yopnano/CtrlAccesPoulduPiscineArduino/docs/Fusion360/Armoire Electrique (Vue ISO).png

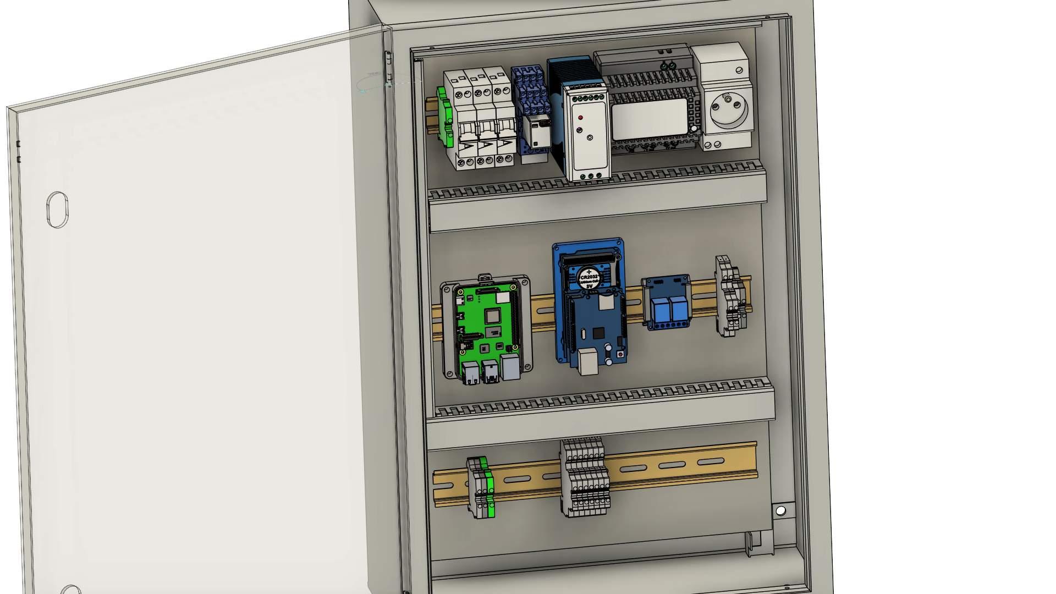
docs/Fusion360/Armoire Electrique (Vue ISO).png
