yopnano/CtrlAccesPoulduPiscineArduino/docs/Fusion360/Armoire 2D.pdf

1 A 2 3 4 5 6 7 8 1 2 3 4 5 6 7 8 FEDCB FEDCBA Dept. Technical reference Created by Approved by Title DWG No. Document type Document status Rev. Date of issue Sheet 24/03/2025 B 15/03/2025 1/1 Piscine Contrôle d'accès Yann Herledan Q1 Q2 Q3 KA1 A1 PC Raspberry PI Arduino RTC X2 X3 KA2 KA3 X1 X4 Repère Désignation Q1 Disjoncteur 16A (Prise) Q2 Disjoncteur 2A (Alimentation) Q3 Disjoncteur 2A (Onduleur) KA1 Relais de présence tension A1 Alimentation 5V 10A 50W (Système) A2 Alimentation 12V 5A 60W (Ventouse) PC Prise de courant console Raspberry PI Raspberry Pi 4B+ 4Go ram RTC Module d'horloge temps réel Arduino Arduino Mega 2560 + Ethernet Shield KA2 Relais de pilotage ventouse magnétique KA3 Relais maintien alimentation ondulée X1 Bornier de source d'alimentation secteur X2 Bornier de distribution terre X3 Bornier de distribution 5V et 5V (batterie) X4 (Ventouse, Bouton poussoir, Digicode RFID) Bornier de raccordement périphérie exterieur A2

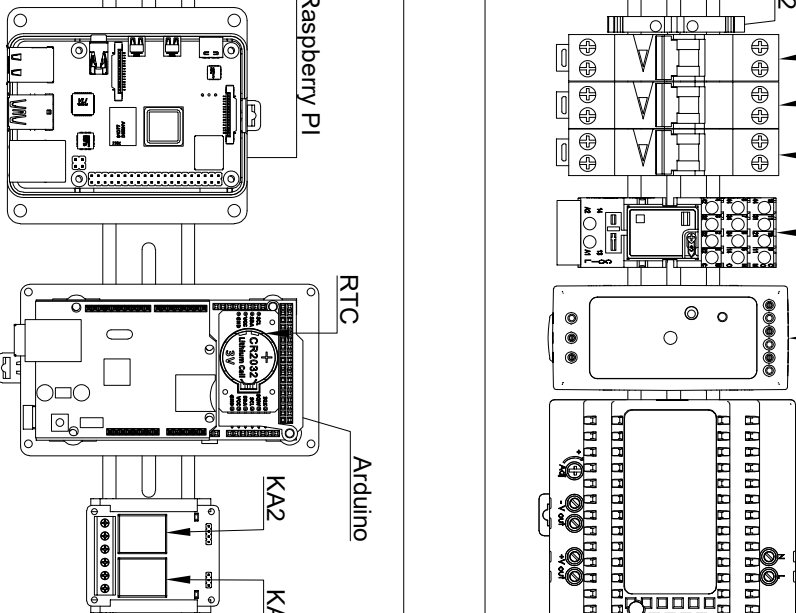
[picture p2: figure]
