yopnano/CtrlAccesPoulduPiscineArduino/docs/Schemaplic/Schema (rev B).pdf

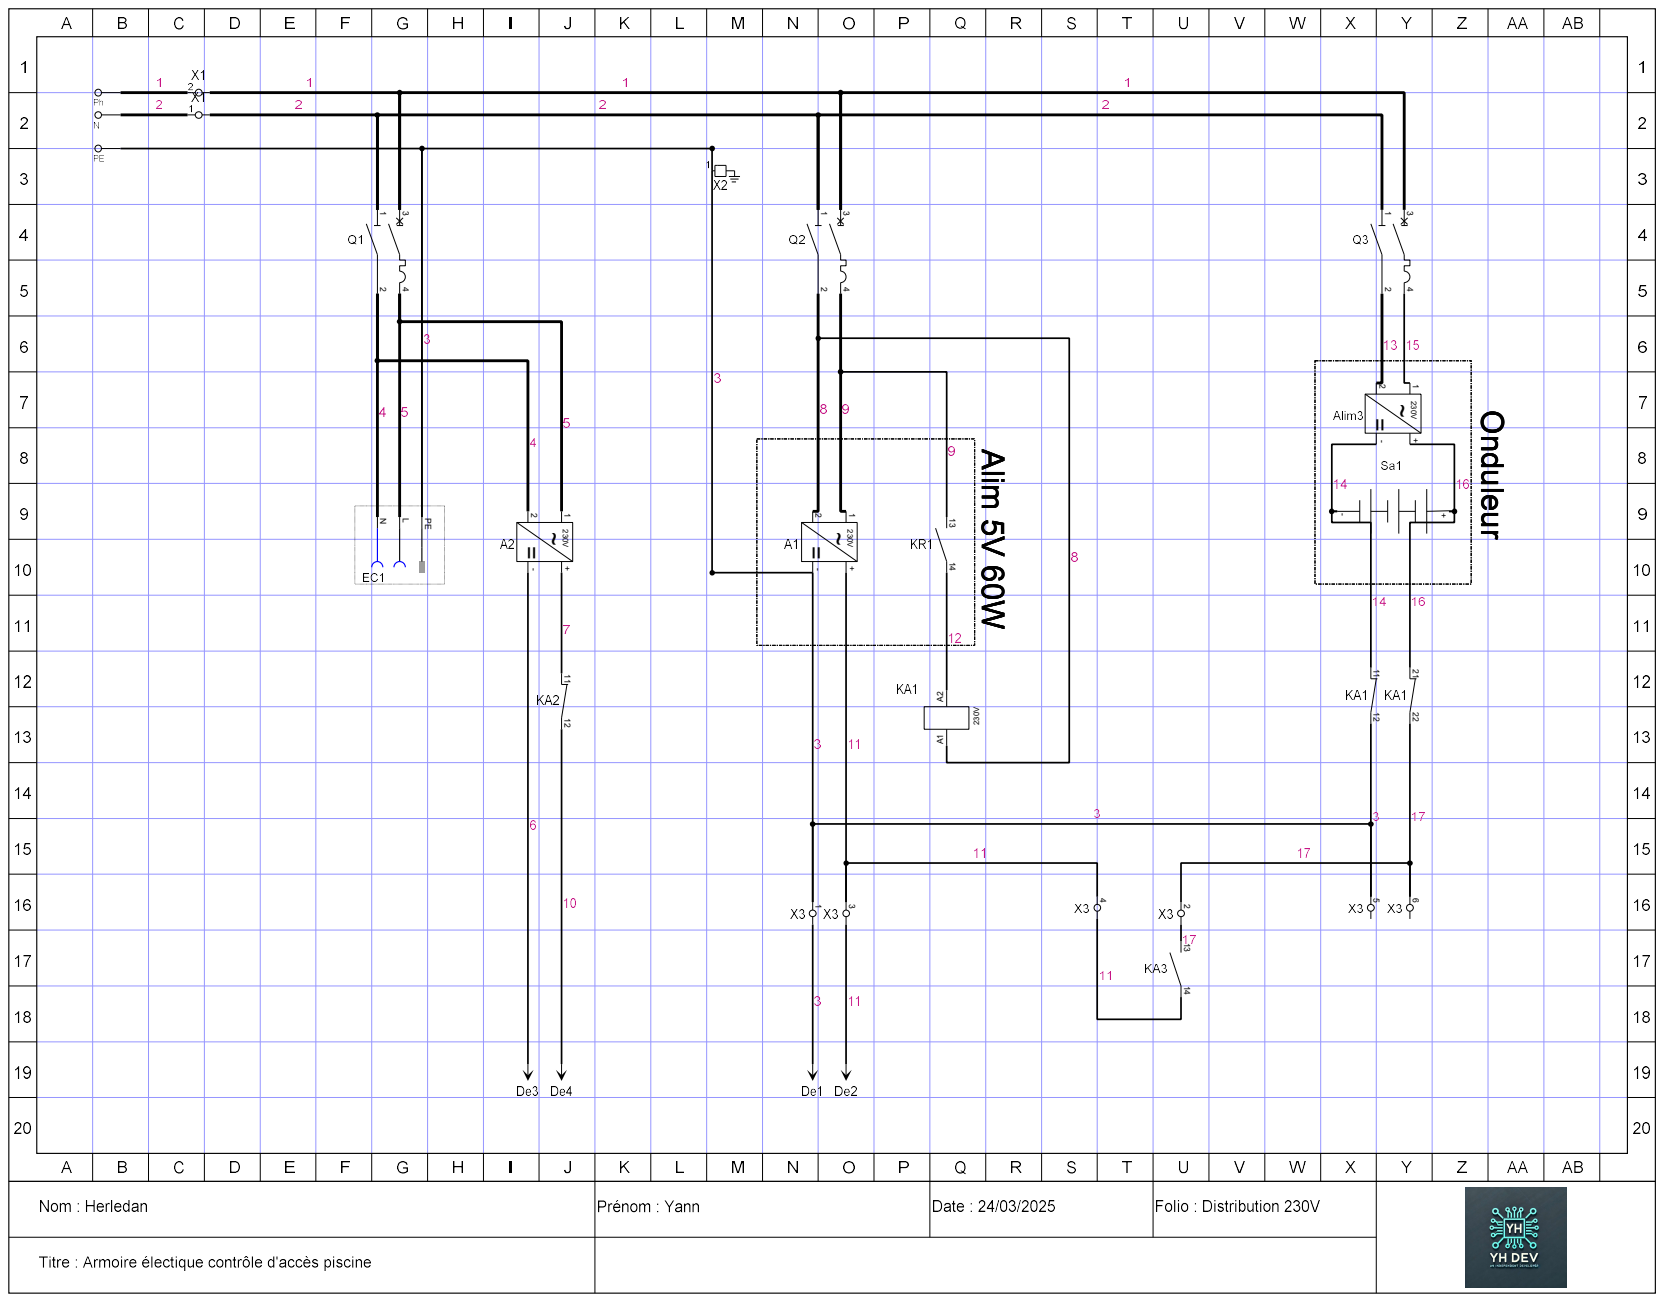
[picture p3: page 1]

Alim 5V 60W Onduleur 13 24 11 12 21 22 13 13 14 230V A1 A2 ~=230V 21 -+ ~=230V 21 -+ -+ 13 14 NLPE 13 24 13 24 2456 ~=230V 21 -+ 11 12

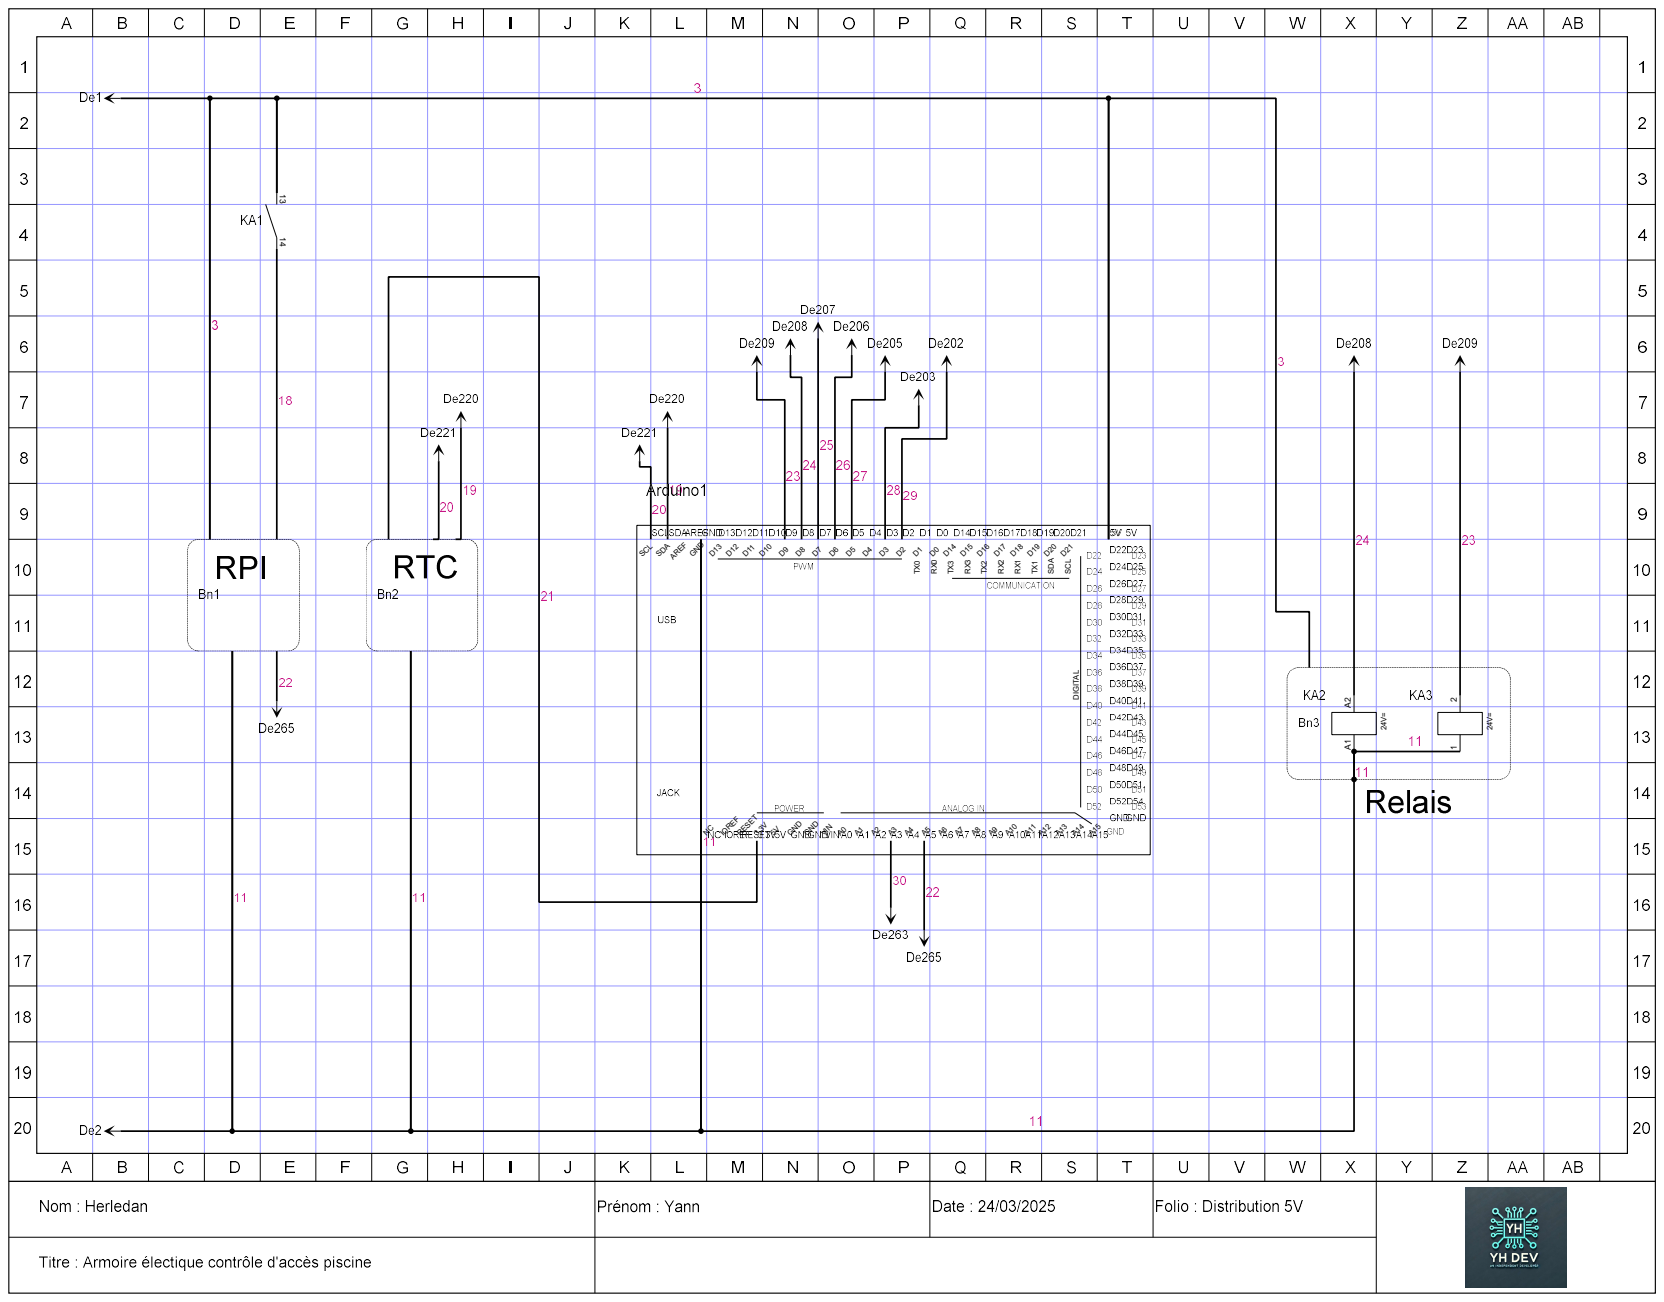
[picture p4: page 2]

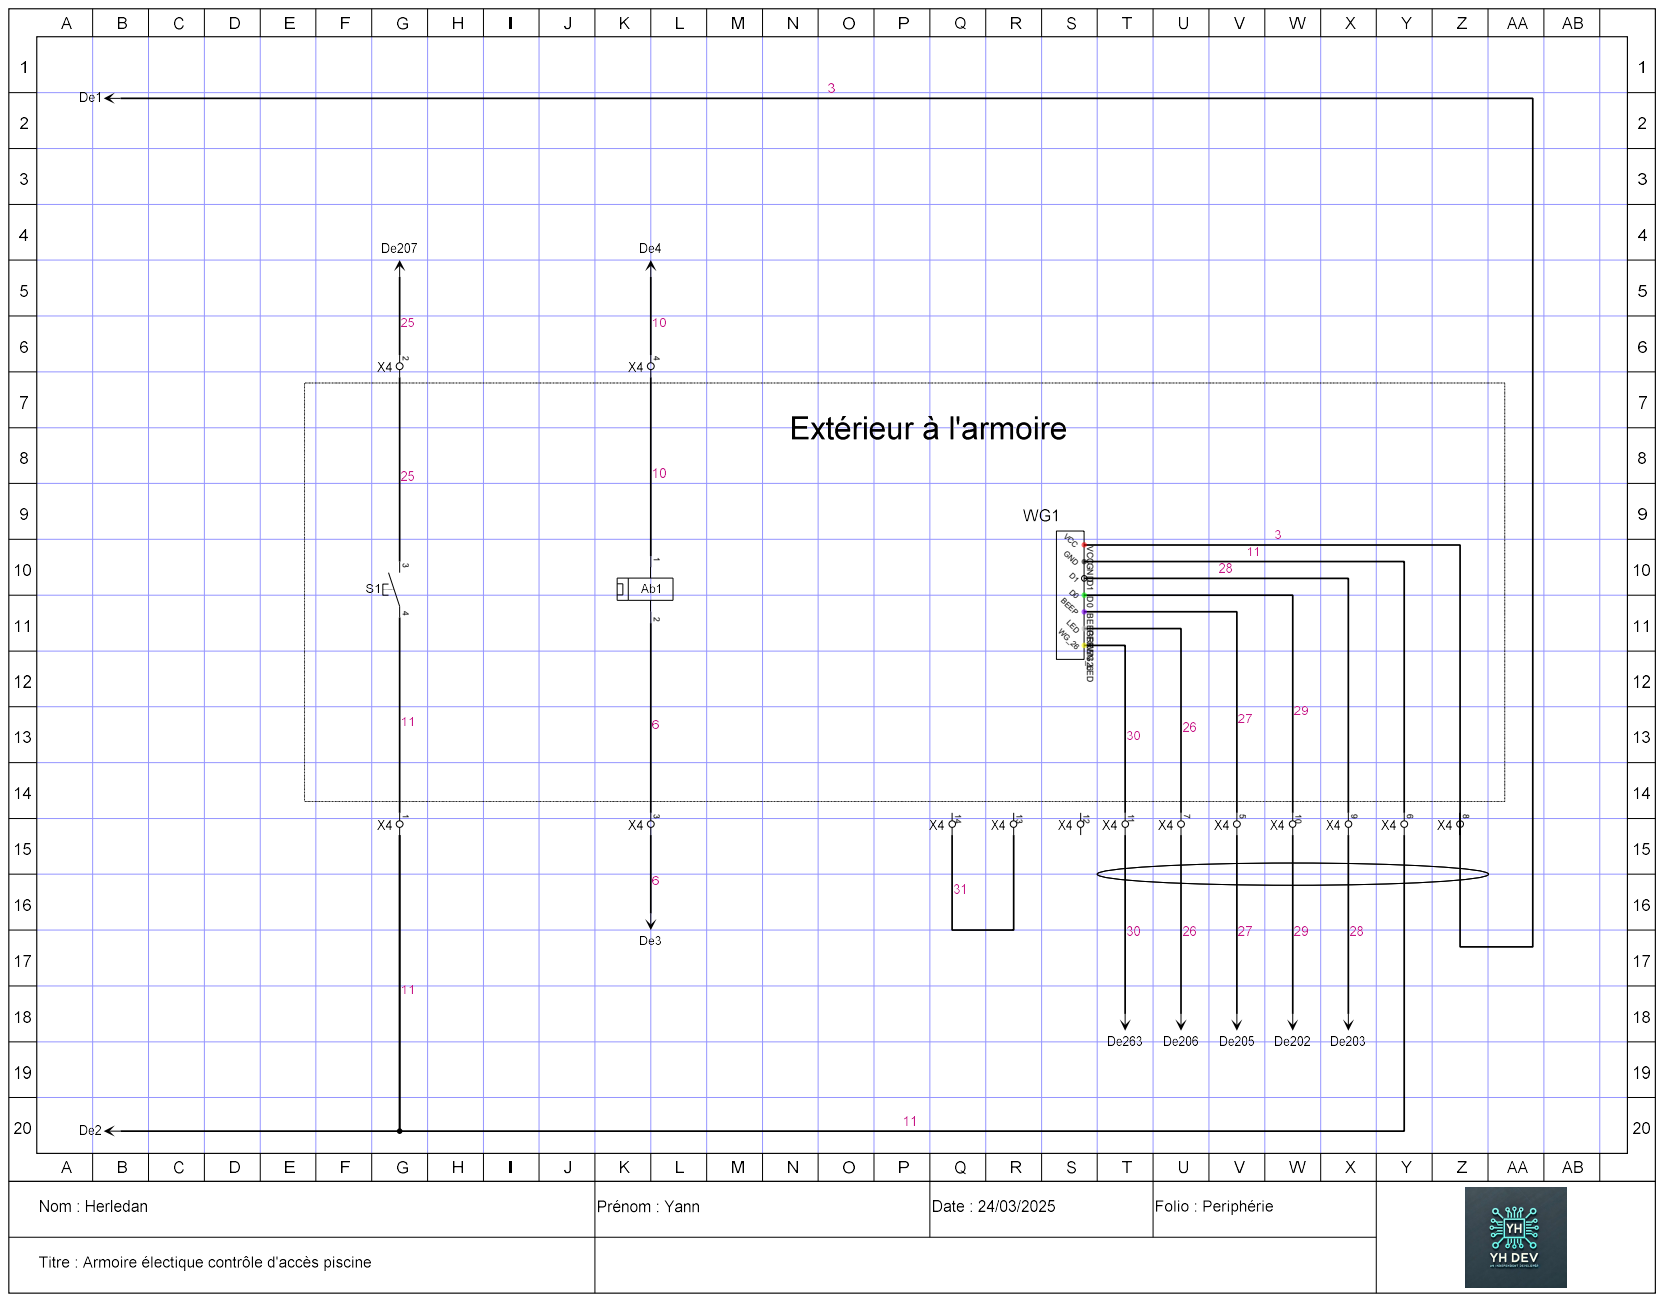
[picture p5: page 3]
3 4 2 1 VCCGND D1 D0 BEEPLEWG_26 D VCCGNDD1 D0 BEEPER GREEN_LED WG26 12117510968 4 3 1 2 1413

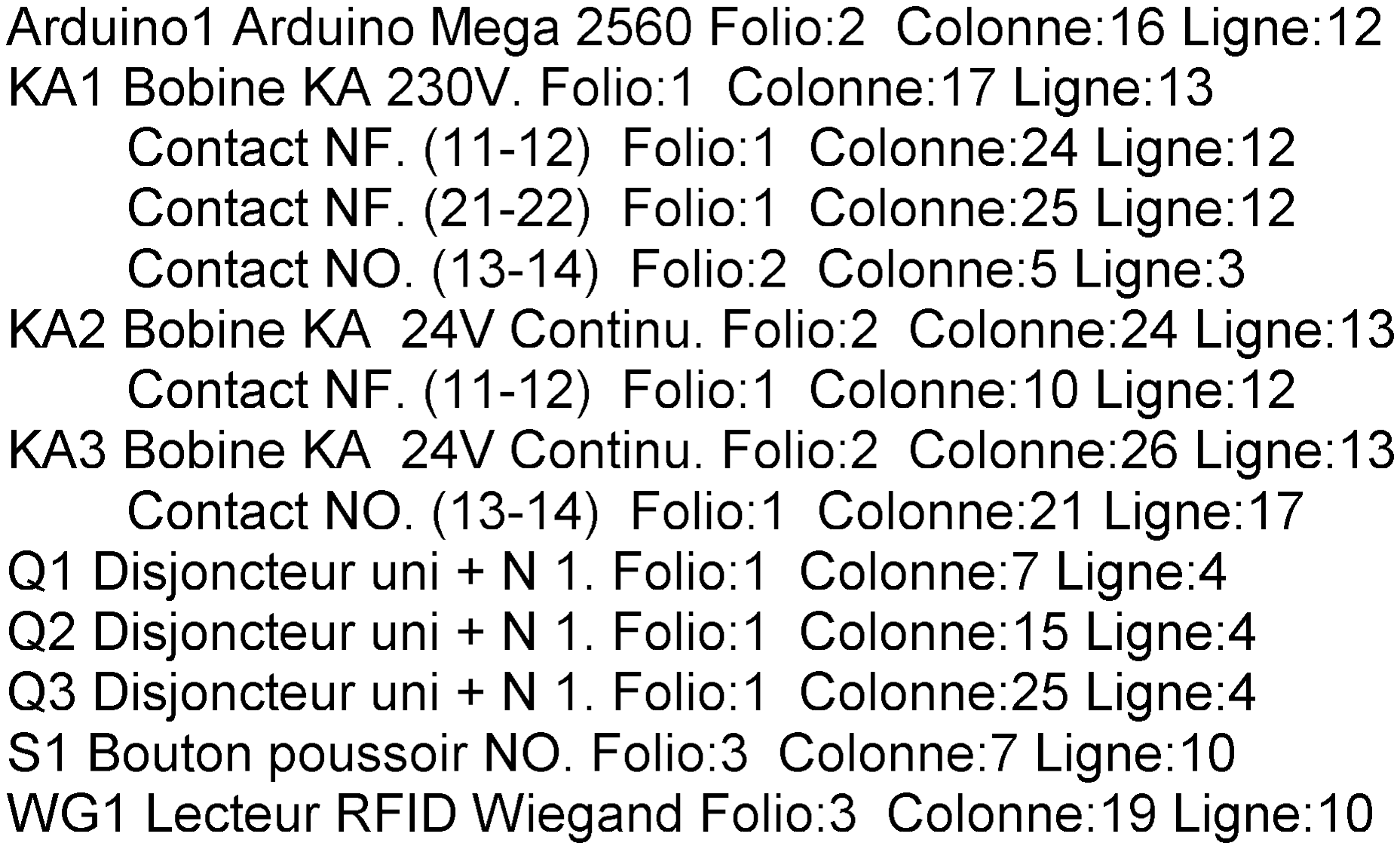
[picture p6: figure]
