yopnano/CtrlAccesPoulduPiscineArduino/docs/Fusion360/Armoire Electrique (Vue de Face).png

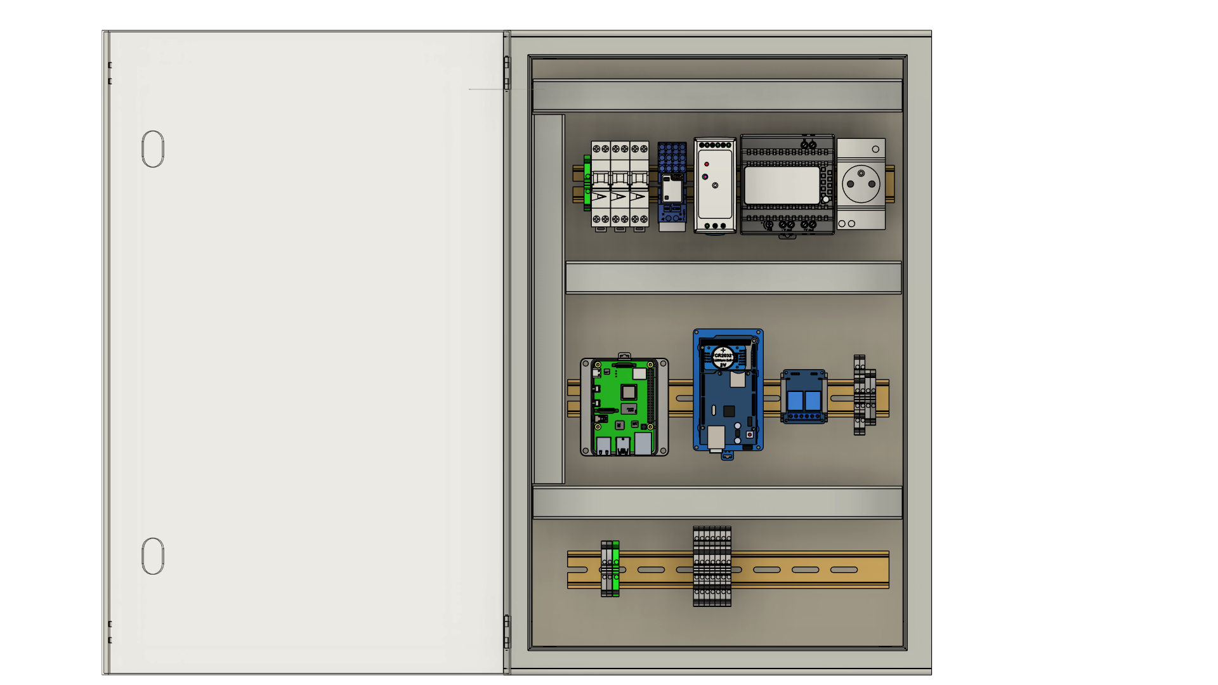
docs/Fusion360/Armoire Electrique (Vue de Face).png
