yopnano/CtrlAccesPoulduPiscineArduino/(list of files, cad)

Other CAD files:
docs/Fusion360/Bornier_Double.f3d
docs/Fusion360/Capuchon_Prise_Jack_Onduleur.f3d
docs/Fusion360/Finder s55+94 v3.f3d
