yopnano/CtrlAccesPoulduPiscineArduino/(list of files, drawings)

Other design files:
docs/Fritzing/CtrlAccesPiscinePouldu.fzz
