yopnano/CtrlAccesPoulduPiscineArduino/src/Config.h

#ifndef Config_hg
#define Config_hg


#define ProjectName "Contrôle d'accès piscine Pouldu BeOutils [V0.0.1]"

#define UsingLib_Serial
// #define UsingLib_IR
// #define UsingLib_433MHz
// #define UsingLib_Servo
// #define UsingLib_LcdI2c
// #define UsingLib_PID
// #define UsingLib_RTC



#endif // Config_hg
