yopnano/CtrlAccesPoulduPiscineArduino/(commit log)

2024-11-23 Ajout de commentaires
2024-12-04 Augmentation du TimeOut de saisie
2025-02-19 Gestion du relais d'alimentation raspberry
2025-02-19 Ajout de l'adresse ip en debug et commentaire
2025-03-23 Ajout de debug sur RTC
2025-03-23 Ajout de NTP_server en tant que sous module
2025-03-23 Modification de gitIgnore
2025-03-24 Ajout de fichiers de documentation
    [Bornier_Double.f3d, Capuchon_Prise_Jack_Onduleur.f3d, CtrlAccesPiscinePouldu.fzz, CtrlAccesPiscinePouldu.sch, Finder s55+94 v3.f3d]
2025-03-24 Modification de la doc
    [CtrlAccesPiscinePouldu.sch]
2025-07-12 Modification des codes de secours
2025-08-09 Ajout d'une tempo de maintien du relais ups de 30 secondes
2025-08-10 Bug La tempo de déverrouillage passe à 0 secondes corrigé en mettant un temps minimal de 10 secondes pour le bouton et de 5 secondes pour les badges
2025-12-06 feat: Implement ClavierRFID library for RFID and keypad input handling - Integrated BeOutils template - Added ClavierRFID.cpp and ClavierRFID.h for managing RFID and keypad interactions. - Integrated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
    feat: Introduce MQTTManager for MQTT communication
    - Created MQTTManager.h to handle MQTT connections, subscriptions, and message publishing.
    - Added reconnect logic for maintaining MQTT connection stability.
    - Implemented logging for MQTT operations.
    feat: Add RTC_LocalTime for real-time clock management
    - Developed RTC_LocalTime.h to manage RTC modules with local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
    [Config.h, Mapping.h, Params.h, main.cpp]
2025-12-13 Ajout de la journalisation de la tension Raspberry Pi dans la boucle principale
